JeffBasso/pcb-blocks/blocks/poe_pd/poe_pd_sheet.kicad_sch

## KiCad design blocks/poe_pd/poe_pd_sheet.kicad_sch (2026-11-13)

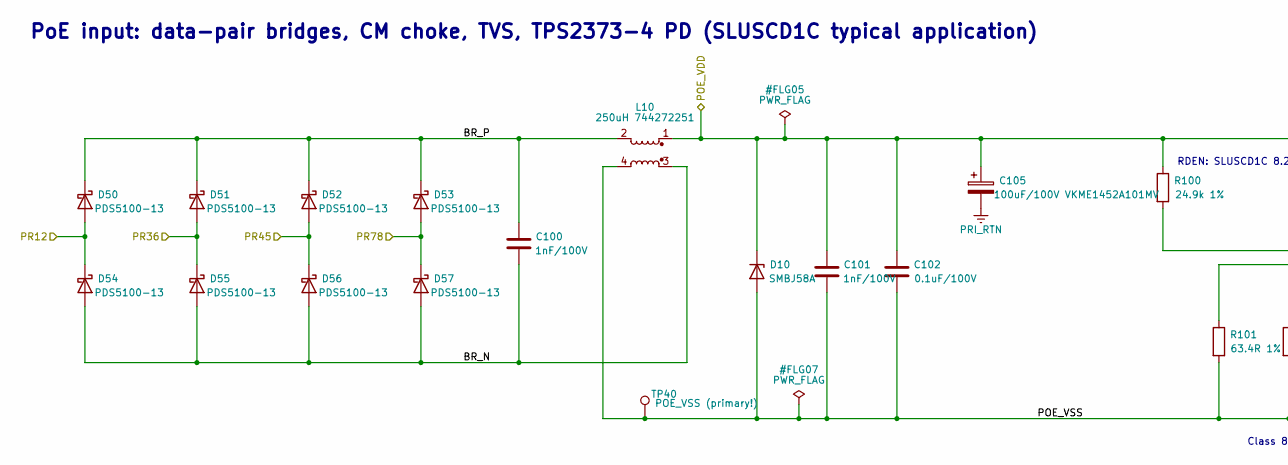
[picture p2: schematic poe_pd_sheet.kicad_sch, part in row 1, column 1]

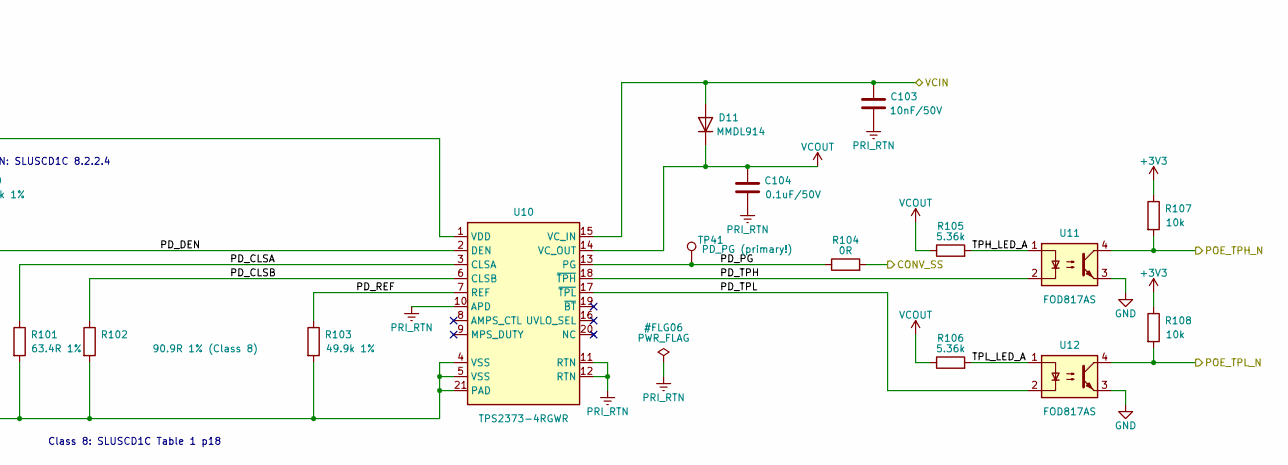
[picture p3: schematic poe_pd_sheet.kicad_sch, part in row 1, column 2]

Parts:
C100, C101: 1nF/100V; C_0603_1608Metric
C102: 0.1uF/100V; C_0805_2012Metric
C103: 10nF/50V; C_0603_1608Metric
C104: 0.1uF/50V; C_0603_1608Metric
C105: 100uF/100V VKME1452A101MV; CP_Elec_10x14.3
D10: SMBJ58A; D_SMB
D11: MMDL914; D_SOD-323
D50, D51, D52, D53, D54, D55, D56, D57: PDS5100-13; D_PowerDI-5
L10: 250uH 744272251; L_CommonModeChoke_Wuerth_WE-SL5
R100: 24.9k 1%; R_0603_1608Metric
R101: 63.4R 1%; R_0603_1608Metric
R102: 90.9R 1% (Class 8); R_0603_1608Metric
R103: 49.9k 1%; R_0603_1608Metric
R104: 0R; R_0603_1608Metric
R105, R106: 5.36k; R_0603_1608Metric
R107, R108: 10k; R_0603_1608Metric
TP40: POE_VSS (primary!); TestPoint_Pad_D1.5mm
TP41: PD_PG (primary!); TestPoint_Pad_D1.0mm
U10: TPS2373-4RGWR; TI_RGW0020B_VQFN-20-1EP_5x5mm_P0.65mm_EP2.2x2.2mm_ThermalVi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
U11, U12: FOD817AS; SMDIP-4_W9.53mm

Connections:
+3V3: R107.1, R108.1
BR_N: C100.2, D54.2 (A), D55.2 (A), D56.2 (A), D57.2 (A), L10.3
BR_P: C100.1, D50.1 (K), D51.1 (K), D52.1 (K), D53.1 (K), L10.2
CONV_SS: R104.2
GND: U11.3, U12.3
PD_CLSA: R101.1, U10.3 (CLSA)
PD_CLSB: R102.1, U10.6 (CLSB)
PD_DEN: R100.2, U10.2 (DEN)
PD_PG: R104.1, TP41.1, U10.13 (PG)
PD_REF: R103.1, U10.7 (REF)
PD_TPH: U10.18 (~TPH), U11.2
PD_TPL: U10.17 (~TPL), U12.2
POE_TPH_N: R107.2, U11.4
POE_TPL_N: R108.2, U12.4
POE_VDD: C101.1, C102.1, C105.1, D10.1 (K), L10.1, R100.1, U10.1 (VDD)
POE_VSS: C101.2, C102.2, D10.2 (A), L10.4, R101.2, R102.2, R103.2, TP40.1, U10.4 (VSS), U10.5 (VSS), U10.21 (PAD)
PR12: D50.2 (A), D54.1 (K)
PR36: D51.2 (A), D55.1 (K)
PR45: D52.2 (A), D56.1 (K)
PR78: D53.2 (A), D57.1 (K)
PRI_RTN: C103.2, C104.2, C105.2, U10.10 (APD), U10.11 (RTN), U10.12 (RTN)
TPH_LED_A: R105.2, U11.1
TPL_LED_A: R106.2, U12.1
VCIN: C103.1, D11.2 (A), U10.15 (VC_IN)
VCOUT: C104.1, D11.1 (K), R105.1, R106.1, U10.14 (VC_OUT)

Notes on the sheet:
RDEN: SLUSCD1C 8.2.2.4
Class 8: SLUSCD1C Table 1 p18
PoE input: data-pair bridges, CM choke, TVS, TPS2373-4 PD (SLUSCD1C typical application)
