JeffBasso/pcb-blocks/(commit log)

2026-11-12 poe_pd block: Python, drawn sheet cut from wallnode-amp, design block, library, tools
    [poe_pd.kicad_sch, poe_pd_sheet.kicad_sch]
2026-11-12 poe_pd: strap for Class 8; power negotiation rules in BLOCK.md
    - R102 (RCLSB) 249R -> 90.9R: Class 8, 62-71 W at the PD (SLUSCD1C Table 1 p18).
    Sheet, design-block copy, Python, JSON, README and PNG updated.
    - BLOCK.md section 4: TPH/TPL code table for a Class 8 PD (Tables 2-3 p19) and the
    firmware rule (start muted, read TPH/TPL, set the limiter); LLDP DLL classification
    (hardware class is the ceiling, checked against 802.3bt task-force text); MAC-derived
    startup stagger with a gradual limiter ramp.
    - check-blocks: parity 0, design block identical; ERC 0 errors.
    [poe_pd.kicad_sch, poe_pd_sheet.kicad_sch]
